janavi2008/JPConnect-4-/BOM.csv

Item | Qty | Supplier | Cost/item | Total Cost | link
PCB manufacture | 5 | JLCPCB | $1.88 | $9.40 | https://cart.jlcpcb.com/quote?spm=jlcpcb.Public.2006
LEDs, resistors, capacitors, switches and a buzzer | 1 | Robu | $4.18 | $4.18 | https://robu.in/
MAX7221 | 2 | Robu | $1.60 | $3.20 | https://robu.in/product/max7221-ic-smd-package-8-digit-led-display-driver-ic/
Estimated total shipping | 1 |  |  | $10.25
