janavi2008/JPConnect-4-/PCBs/JPConnect(4).kicad_pcb

## KiCad design PCBs/JPConnect(4).kicad_pcb (2026-10-11)

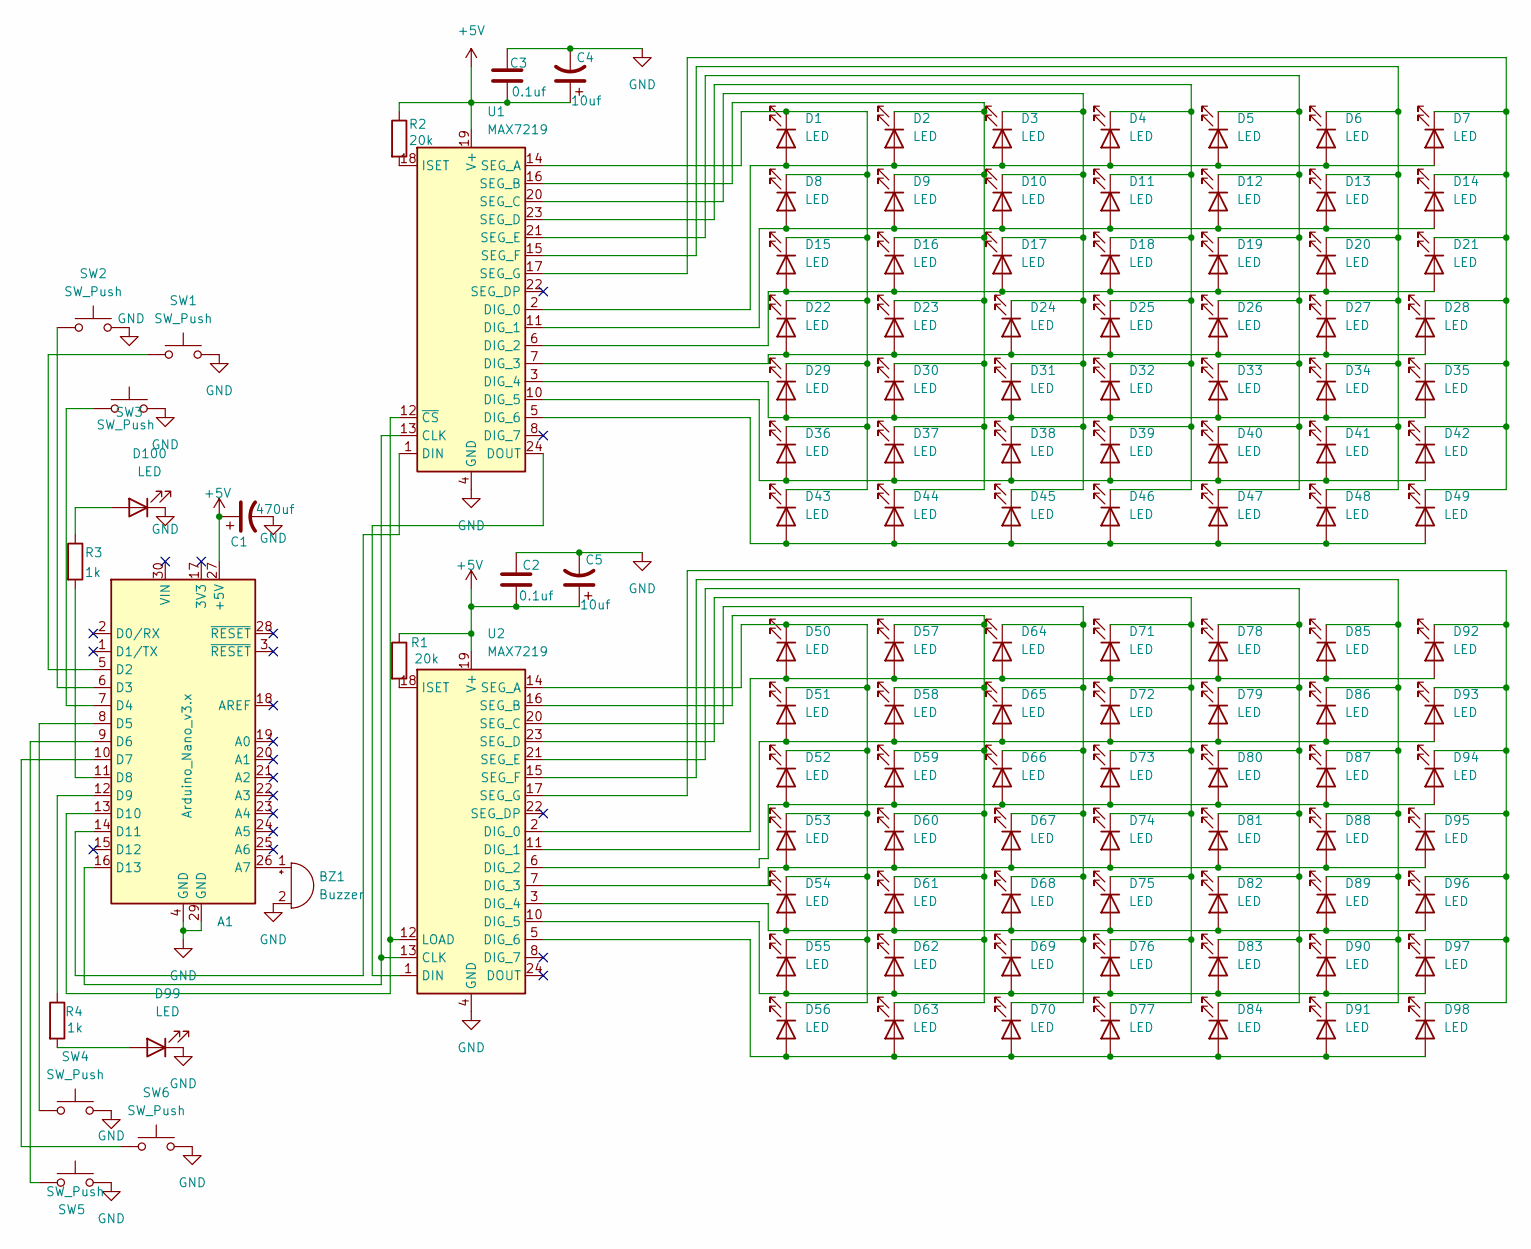
[picture p1: schematic JPConnect(4).kicad_sch]

Parts:
A1: Arduino_Nano_v3.x; Arduino_Nano
BZ1: Buzzer; Buzzer_12x9.5RM7.6
C1: 470uf; CP_Elec_8x10
C2, C3: 0.1uf; C_0805_2012Metric_Pad1.18x1.45mm_HandSolder
C4, C5: 10uf; C_0805_2012Metric_Pad1.18x1.45mm_HandSolder
D1, D2, D3, D4, D5, D6, D7, D8, D9, D10, D11, D12, D13, D14, D15, D16, D17, D18, D19, D20, D21, D22, D23, D24, D25, D26, D27, D28, D29, D30, D31, D32, D33, D34, D35, D36, D37, D38, D39, D40, D41, D42, D43, D44, D45, D46, D47, D48, D49, D50, D51, D52, D53, D54, D55, D56, D57, D58, D59, D60, D61, D62, D63, D64, D65, D66, D67, D68, D69, D70, D71, D72, D73, D74, D75, D76, D77, D78, D79, D80, D81, D82, D83, D84, D85, D86, D87, D88, D89, D90, D91, D92, D93, D94, D95, D96, D97, D98, D99, D100: LED; LED_1206_3216Metric_Pad1.42x1.75mm_HandSolder
R1, R2: 20k; R_0805_2012Metric_Pad1.20x1.40mm_HandSolder
R3, R4: 1k; R_0805_2012Metric_Pad1.20x1.40mm_HandSolder
SW1, SW2, SW3, SW4, SW5, SW6: SW_Push; SW_PUSH-12mm
U1, U2: MAX7219; SOIC-24W_7.5x15.4mm_P1.27mm

Connections:
+5V: A1.27 (+5V), C1.1, C2.2, C3.2, C4.1, C5.1, R1.1, R2.1, U1.19 (V+), U2.19 (V+)
GND: A1.4 (GND), A1.29 (GND), BZ1.2 (-), C1.2, C2.1, C3.1, C4.2, C5.2, D99.1 (K), D100.1 (K), SW1.2, SW2.2, SW3.2, SW4.2, SW5.2, SW6.2, U1.4 (GND), U1.9 (GND), U2.4 (GND), U2.9 (GND)
unnamed: A1.26 (A7), BZ1.1 (+)
unnamed: A1.5 (D2), SW1.1
unnamed: A1.6 (D3), SW2.1
unnamed: A1.7 (D4), SW3.1
unnamed: A1.8 (D5), SW4.1
unnamed: A1.9 (D6), SW5.1
unnamed: A1.10 (D7), SW6.1
unnamed: A1.11 (D8), R3.2
unnamed: A1.12 (D9), R4.1
unnamed: A1.13 (D10), U1.12 (~CS), U2.12 (LOAD)
unnamed: A1.14 (D11), U1.1 (DIN)
unnamed: A1.16 (D13), U1.13 (CLK), U2.13 (CLK)
unnamed: D1.2 (A), D2.2 (A), D3.2 (A), D4.2 (A), D5.2 (A), D6.2 (A), D7.2 (A), U1.2 (DIG_0)
unnamed: D1.1 (K), D8.1 (K), D15.1 (K), D22.1 (K), D29.1 (K), D36.1 (K), D43.1 (K), U1.14 (SEG_A)
unnamed: D8.2 (A), D9.2 (A), D10.2 (A), D11.2 (A), D12.2 (A), D13.2 (A), D14.2 (A), U1.11 (DIG_1)
unnamed: D3.1 (K), D10.1 (K), D17.1 (K), D24.1 (K), D31.1 (K), D38.1 (K), D45.1 (K), U1.20 (SEG_C)
unnamed: D4.1 (K), D11.1 (K), D18.1 (K), D25.1 (K), D32.1 (K), D39.1 (K), D46.1 (K), U1.23 (SEG_D)
unnamed: D5.1 (K), D12.1 (K), D19.1 (K), D26.1 (K), D33.1 (K), D40.1 (K), D47.1 (K), U1.21 (SEG_E)
unnamed: D6.1 (K), D13.1 (K), D20.1 (K), D27.1 (K), D34.1 (K), D41.1 (K), D48.1 (K), U1.15 (SEG_F)
unnamed: D7.1 (K), D14.1 (K), D21.1 (K), D28.1 (K), D35.1 (K), D42.1 (K), D49.1 (K), U1.17 (SEG_G)
unnamed: D15.2 (A), D16.2 (A), D17.2 (A), D18.2 (A), D19.2 (A), D20.2 (A), D21.2 (A), U1.6 (DIG_2)
unnamed: D2.1 (K), D9.1 (K), D16.1 (K), D23.1 (K), D30.1 (K), D37.1 (K), D44.1 (K), U1.16 (SEG_B)
unnamed: D22.2 (A), D23.2 (A), D24.2 (A), D25.2 (A), D26.2 (A), D27.2 (A), D28.2 (A), U1.7 (DIG_3)
unnamed: D29.2 (A), D30.2 (A), D31.2 (A), D32.2 (A), D33.2 (A), D34.2 (A), D35.2 (A), U1.3 (DIG_4)
unnamed: D36.2 (A), D37.2 (A), D38.2 (A), D39.2 (A), D40.2 (A), D41.2 (A), D42.2 (A), U1.10 (DIG_5)
unnamed: D43.2 (A), D44.2 (A), D45.2 (A), D46.2 (A), D47.2 (A), D48.2 (A), D49.2 (A), U1.5 (DIG_6)
unnamed: D50.2 (A), D57.2 (A), D64.2 (A), D71.2 (A), D78.2 (A), D85.2 (A), D92.2 (A), U2.2 (DIG_0)
unnamed: D50.1 (K), D51.1 (K), D52.1 (K), D53.1 (K), D54.1 (K), D55.1 (K), D56.1 (K), U2.14 (SEG_A)
unnamed: D51.2 (A), D58.2 (A), D65.2 (A), D72.2 (A), D79.2 (A), D86.2 (A), D93.2 (A), U2.11 (DIG_1)
unnamed: D52.2 (A), D59.2 (A), D66.2 (A), D73.2 (A), D80.2 (A), D87.2 (A), D94.2 (A), U2.6 (DIG_2)
unnamed: D53.2 (A), D60.2 (A), D67.2 (A), D74.2 (A), D81.2 (A), D88.2 (A), D95.2 (A), U2.7 (DIG_3)
unnamed: D54.2 (A), D61.2 (A), D68.2 (A), D75.2 (A), D82.2 (A), D89.2 (A), D96.2 (A), U2.3 (DIG_4)
unnamed: D55.2 (A), D62.2 (A), D69.2 (A), D76.2 (A), D83.2 (A), D90.2 (A), D97.2 (A), U2.10 (DIG_5)
unnamed: D56.2 (A), D63.2 (A), D70.2 (A), D77.2 (A), D84.2 (A), D91.2 (A), D98.2 (A), U2.5 (DIG_6)
unnamed: D57.1 (K), D58.1 (K), D59.1 (K), D60.1 (K), D61.1 (K), D62.1 (K), D63.1 (K), U2.16 (SEG_B)
unnamed: D64.1 (K), D65.1 (K), D66.1 (K), D67.1 (K), D68.1 (K), D69.1 (K), D70.1 (K), U2.20 (SEG_C)
unnamed: D71.1 (K), D72.1 (K), D73.1 (K), D74.1 (K), D75.1 (K), D76.1 (K), D77.1 (K), U2.23 (SEG_D)
unnamed: D78.1 (K), D79.1 (K), D80.1 (K), D81.1 (K), D82.1 (K), D83.1 (K), D84.1 (K), U2.21 (SEG_E)
unnamed: D85.1 (K), D86.1 (K), D87.1 (K), D88.1 (K), D89.1 (K), D90.1 (K), D91.1 (K), U2.15 (SEG_F)
unnamed: D92.1 (K), D93.1 (K), D94.1 (K), D95.1 (K), D96.1 (K), D97.1 (K), D98.1 (K), U2.17 (SEG_G)
unnamed: D99.2 (A), R4.2
unnamed: D100.2 (A), R3.1
unnamed: U1.24 (DOUT), U2.1 (DIN)
unnamed: R2.2, U1.18 (ISET)
unnamed: R1.2, U2.18 (ISET)

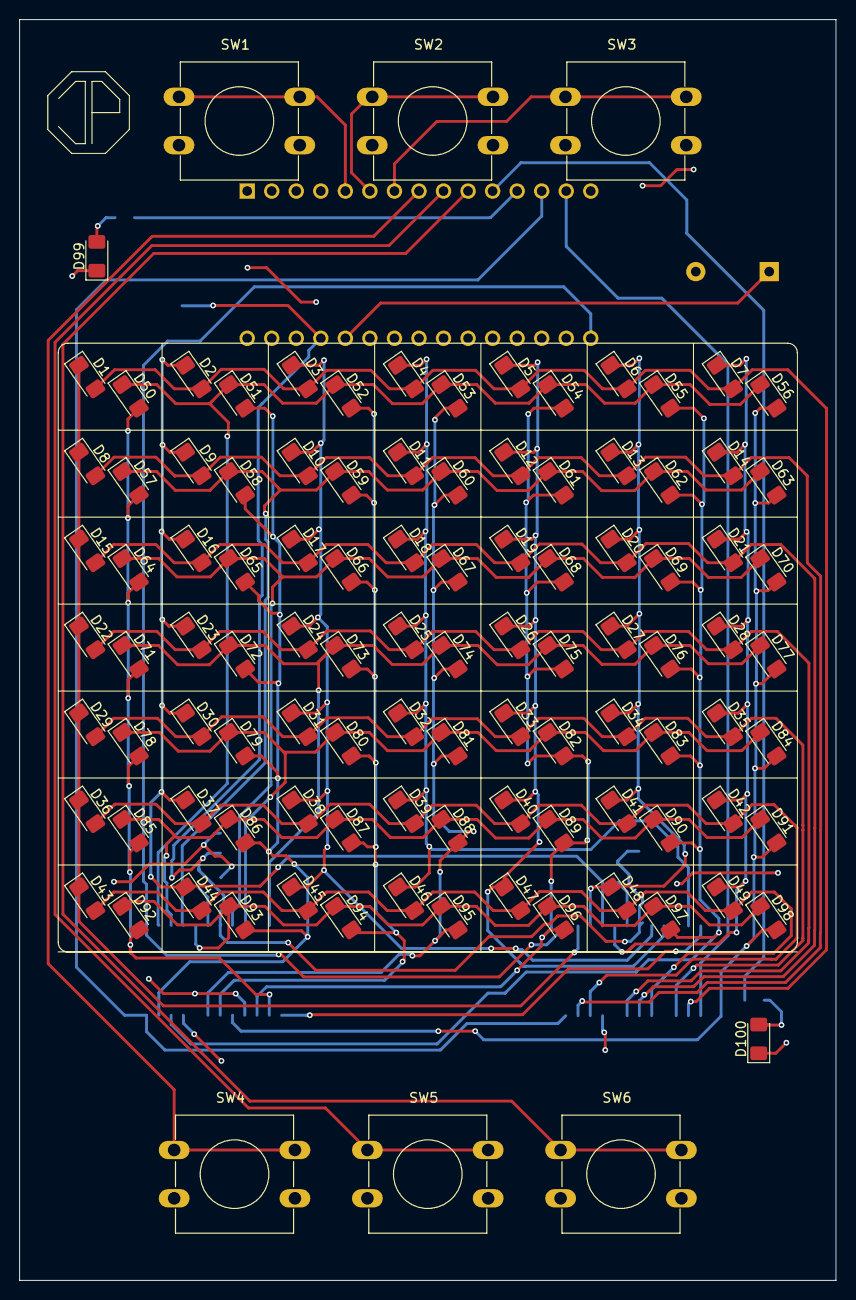
[picture p2: board JPConnect(4).kicad_pcb from above]

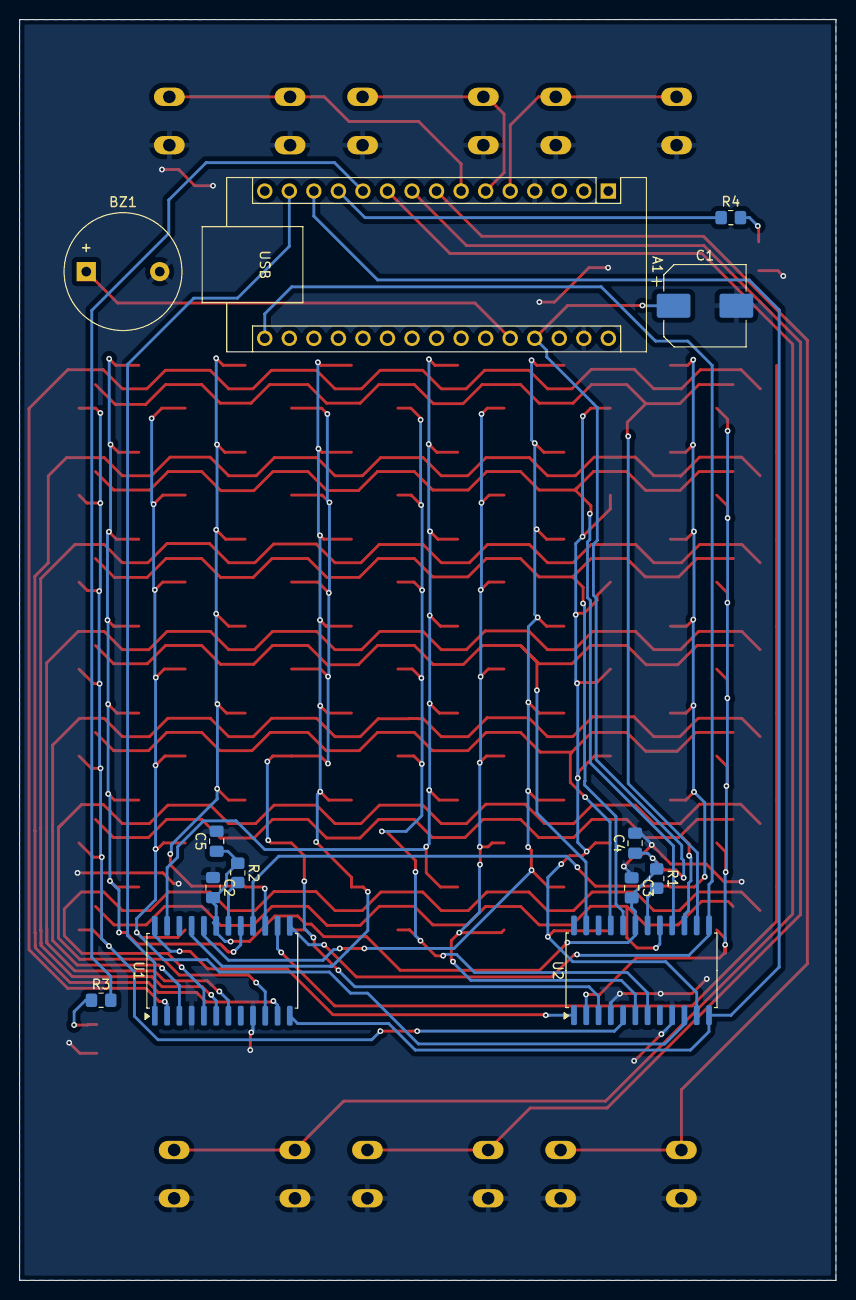
[picture p3: board JPConnect(4).kicad_pcb from below]

Board: 2 copper layers, 84.5 x 130.5 mm, 119 parts (13 on the bottom side), 47 nets.
