janavi2008/JPConnect-4-/JOURNAL.md

# JPConnect(4) – devlog

<!-- Generated by Half Life from project cmuuz3xoz0bss01smhv4qlqnl. Edits here are overwritten on the next sync. -->
<!-- Generated: 2026-10-11T20:21:34.739Z -->

> [!NOTE]
> This devlog is mirrored from [Half Life](https://halflife.hackclub.com) – [open the project](https://halflife.hackclub.com/projects/cmuuz3xoz0bss01smhv4qlqnl). Editing it here will not change the platform's copy, and the next sync overwrites this file.

> a 2-player connect 4 game with a minimalist vibe- no screens,  just some leds and buttons!

| Week | Tier | Hours logged | Entries |
| --- | --- | --- | --- |
| Week 1 | Tier 1 | 11.97h | 5 |

## Contents

1. [2026-10-06 – Completed the schematic design in kicad](#2026-10-06-completed-the-schematic-design-in-kicad)
2. [2026-10-07 – Started routing the pcb for the connect 4 game today. i decided to switch to using smd components as it looks cleaner. im done with around 2/3 of the routing, but the next stretch is gonna be tight, s](#2026-10-07-started-routing-the-pcb-for-the-connect-4-game-to)
3. [2026-10-08 – Finished routing the pcb, and it was just as painful as i expected. its a huge mess, but drc came back clean, so hopefully we're good to go! i made a small logo in the corner too. i also spent an hour](#2026-10-08-finished-routing-the-pcb-and-it-was-just-as-painf)
4. [2026-10-10 – I realised i hadnt really added any design rules, so i set minimum clearances and increased track width, and then spent an hour fixing all the errors it created](#2026-10-10-i-realised-i-hadnt-really-added-any-design-rules-)
5. [2026-10-11 – I added some finishing touches to the pcb, drawing a grid around the leds, and adding some text. i also cleaned up the traces as much as i could, and triple checked the pcb as well as the schematic, a](#2026-10-11-i-added-some-finishing-touches-to-the-pcb-drawing)

## Design

### 2026-10-06 – Completed the schematic design in kicad

**2.12h**

Completed the schematic design in kicad

[Timelapse](https://lookout.hackclub.com/api/media/c240a5f6-47f8-47d9-891d-48b65a5ba11f/video.mp4)

### 2026-10-07 – Started routing the pcb for the connect 4 game today. i decided to switch to using smd components as it looks cleaner. im done with around 2/3 of the routing, but the next stretch is gonna be tight, s

**3.45h**

Started routing the pcb for the connect 4 game today. i decided to switch to using smd components as it looks cleaner. im done with around 2/3 of the routing, but the next stretch is gonna be tight, so thats fun.
my progress:





[Timelapse](https://lookout.hackclub.com/api/media/87cf1816-e4ea-486f-986c-96456da35549/video.mp4)

### 2026-10-08 – Finished routing the pcb, and it was just as painful as i expected. its a huge mess, but drc came back clean, so hopefully we're good to go! i made a small logo in the corner too. i also spent an hour

**3.68h**

Finished routing the pcb, and it was just as painful as i expected. its a huge mess, but drc came back clean, so hopefully we're good to go! i made a small logo in the corner too. i also spent an hour researching and figuring out how to code the firmware, reading the datasheet for the MAX7219, and going through its code library - i dont have much experience coding, so the more info i get, the better.



[Timelapse](https://lookout.hackclub.com/api/media/82983018-d48d-4568-bb3a-cd816c222c67/video.mp4)

### 2026-10-10 – I realised i hadnt really added any design rules, so i set minimum clearances and increased track width, and then spent an hour fixing all the errors it created

**1.22h**

I realised i hadnt really added any design rules, so i set minimum clearances and increased track width, and then spent an hour fixing all the errors it created

[Timelapse](https://lookout.hackclub.com/api/media/0fb3a418-f9cf-433d-99e7-1b86d59446fa/video.mp4)

### 2026-10-11 – I added some finishing touches to the pcb, drawing a grid around the leds, and adding some text. i also cleaned up the traces as much as i could, and triple checked the pcb as well as the schematic, a

**1.5h**

I added some finishing touches to the pcb, drawing a grid around the leds, and adding some text. i also cleaned up the traces as much as i could, and triple checked the pcb as well as the schematic, and corrected a few wrong connections.
i added all the parts to cart on robu, but i found that my led driver chips (MAX7219) were out of stock. so i had to find a replacement at the last minute, with as few changes as possible. thankfully the MAX7221 was available, and it is pretty much interchangable with the 7219.
i wrote the first version of the firmware (i logged the time for coding separately via hacktime, just wanted to mention it) and its probably not the most efficient code but it was the best i could do.
here's my final pcb!
