janavi2008/JPConnect-4-/(commit log)

2026-10-16 Sync JPConnect(4) from Half Life
    [BOM.csv]
2026-10-16 Rename Untitled spreadsheet - Sheet1.csv to BOM.csv
    [BOM.csv]
2026-10-23 Rename Untitled spreadsheet - Sheet1 (2).csv to BOM.csv
    [BOM.csv]
